m888r/scr23-ir-can/scr23-ir-can-library/ul_LQH44PH4R7MPRL/IND_LQH44_MUR.step

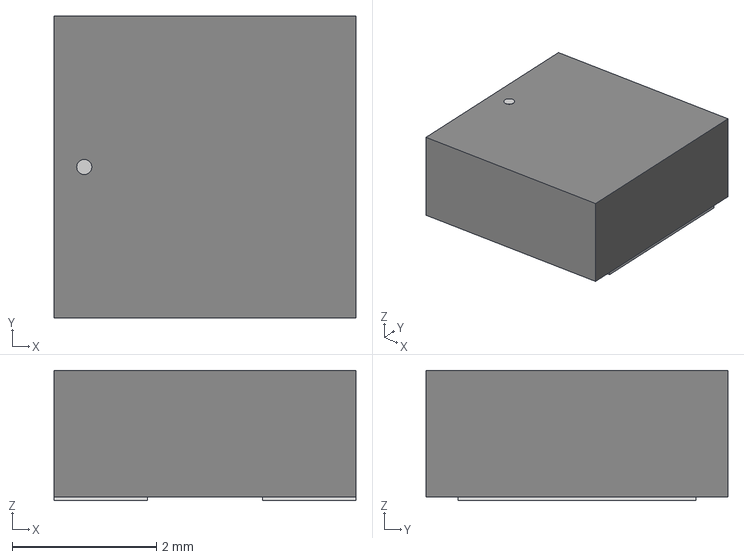
[picture p1: CAD file, 2023-03-10]
scr23-ir-can-library/ul_LQH44PH4R7MPRL/IND_LQH44_MUR.step
4.19 x 4.19 x 1.81 mm
