m888r/scr23-ir-can/scr23-ir-can-library/MLX90640ESF-BAB-000-TU/MLX90640ESF-BAB-000-TU.step

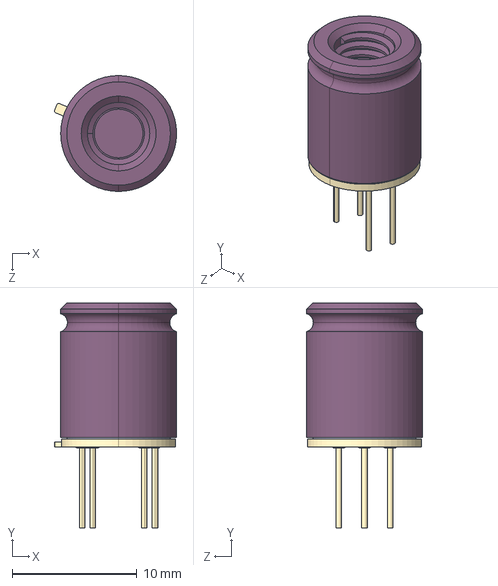
[picture p2: CAD file, 2023-03-10]
scr23-ir-can-library/MLX90640ESF-BAB-000-TU/MLX90640ESF-BAB-000-TU.step
9.80 x 18.1 x 9.30 mm
