m888r/scr23-ir-can/scr23-ir-can-library/Molex SolderRight/172677-0100.stp

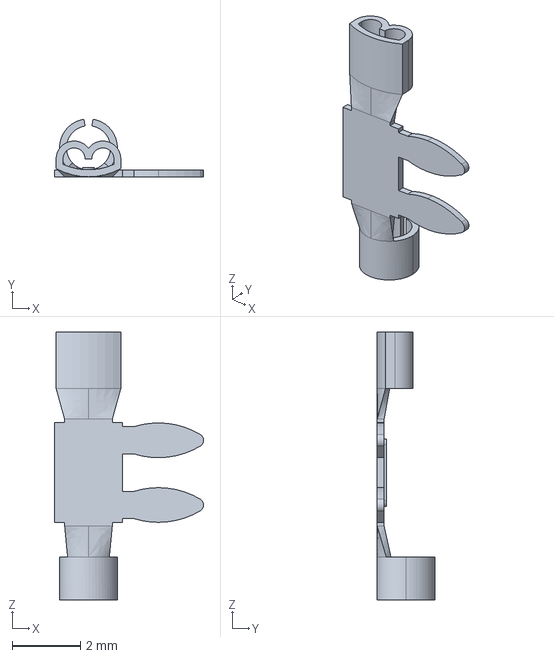
[picture p3: CAD file, 2023-03-10]
scr23-ir-can-library/Molex SolderRight/172677-0100.stp
4.38 x 1.69 x 7.87 mm
