m888r/scr23-ir-can/firmware/scr23-ir-can.ioc

Mcu.UserName=STM32L431KBUx
PA10.Signal=I2C1_SDA
PA11.Signal=CAN1_RX
PA12.Signal=CAN1_TX
PA9.Signal=I2C1_SCL
