m888r/scr23-ir-can/(commit log)

2023-03-10 add all components, still need to do uC i2c connections and decoupling caps
    [IND_LQH44_MUR.step, scr23-ir-can.kicad_pcb, scr23-ir-can.kicad_sch]
2023-03-11 schematic done, added stdc14 programming connector
    [scr23-ir-can.kicad_pcb, scr23-ir-can.kicad_sch]
2023-03-11 add edge cuts
    [scr23-ir-can.kicad_pcb]
2023-03-11 added comment for maybe replacing the STDC14 thing
    [scr23-ir-can.kicad_pcb]
2023-03-12 change to a through hole 2x7 for programming
    [scr23-ir-can.kicad_pcb, scr23-ir-can.kicad_sch]
2023-03-12 misc changes to layout, need to move everything to same layer
    [scr23-ir-can.kicad_pcb]
2023-03-13 better layout lol
    [scr23-ir-can.kicad_pcb]
2023-03-14 change programming boi to 1.27mm instead of 2.54, i had it wrong
    [scr23-ir-can.kicad_pcb, scr23-ir-can.kicad_sch]
2023-03-14 pcb finished
    [scr23-ir-can.kicad_pcb, scr23-ir-can.kicad_sch]
2023-03-14 ok NOW the pcb is done
    [scr23-ir-can.kicad_pcb]
2023-03-14 add labels to the solderright bois
    [scr23-ir-can.kicad_pcb]
